steflayanto/environmental-chamber/better pics/IMG_0495.jpg

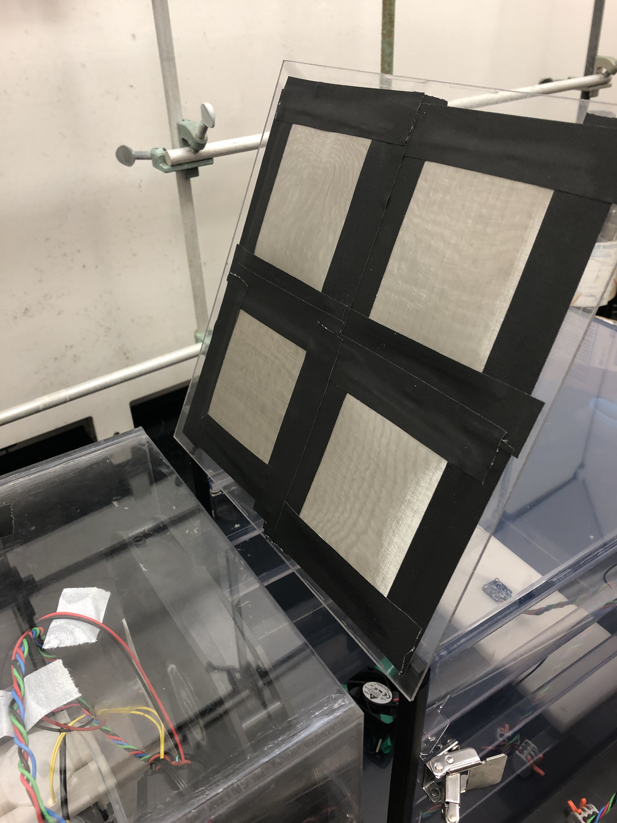
better pics/IMG_0495.jpg
