steflayanto/environmental-chamber/better pics/IMG_0489.jpg

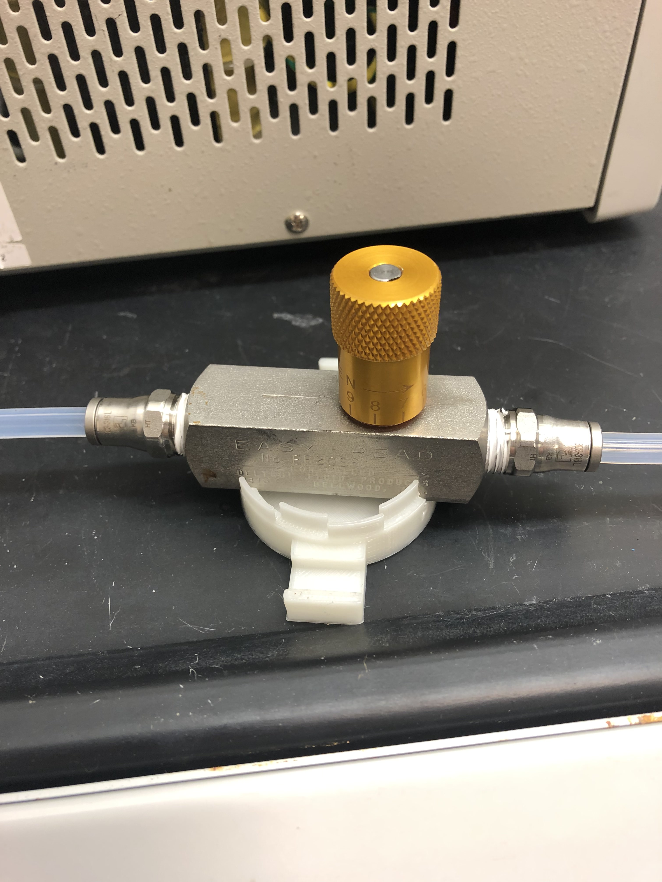
better pics/IMG_0489.jpg
