steflayanto/environmental-chamber/Test_Data/nomesh/8-20-19-nomesh notes.txt

humidifier started at 50 second mark for test
humidifier off at 693 second mark
