steflayanto/environmental-chamber/better pics/IMG_0487.jpg

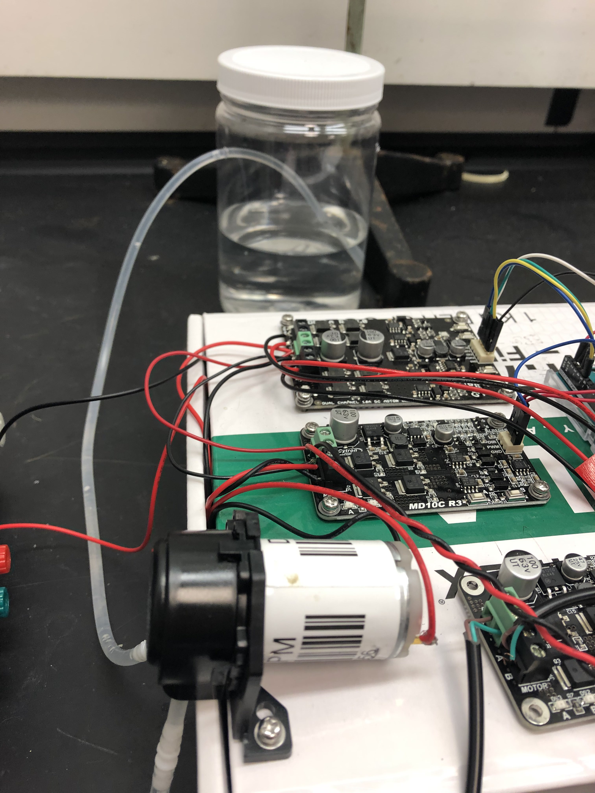
better pics/IMG_0487.jpg
