steflayanto/environmental-chamber/better pics/IMG_0488.jpg

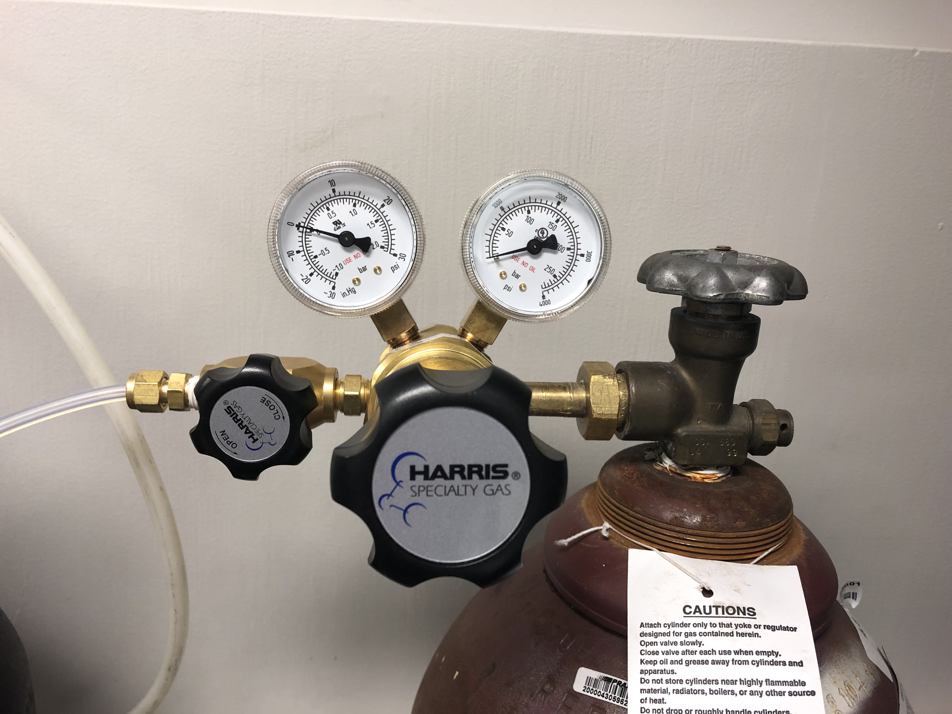
better pics/IMG_0488.jpg
