steflayanto/environmental-chamber/better pics/IMG_0490.jpg

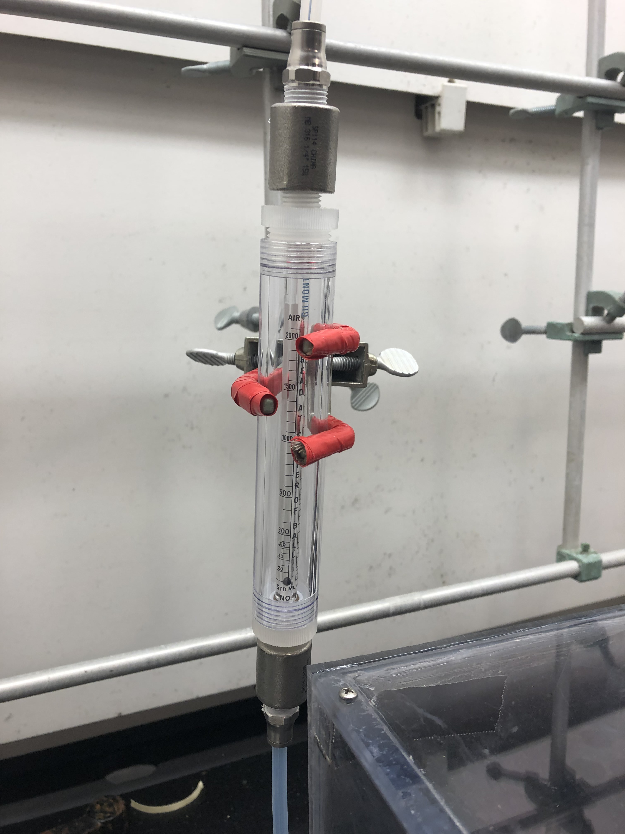
better pics/IMG_0490.jpg
