steflayanto/environmental-chamber/better pics/IMG_0491.jpg

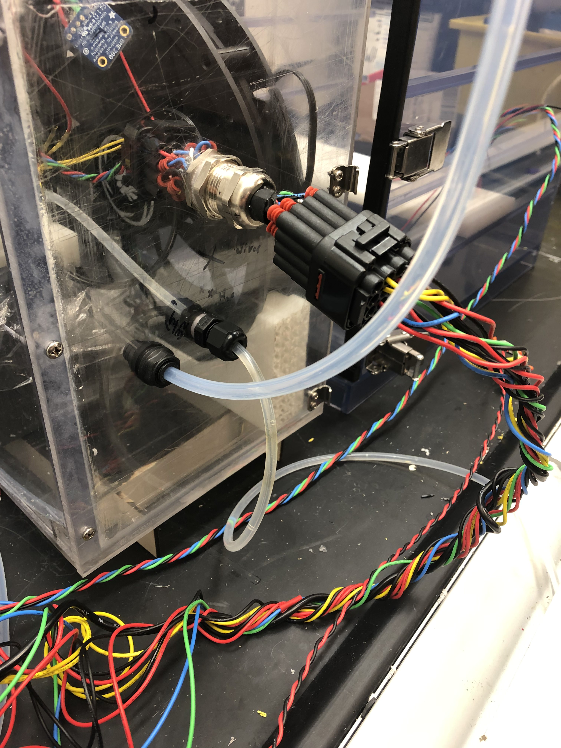
better pics/IMG_0491.jpg
