steflayanto/environmental-chamber/better pics/IMG_0492.jpg

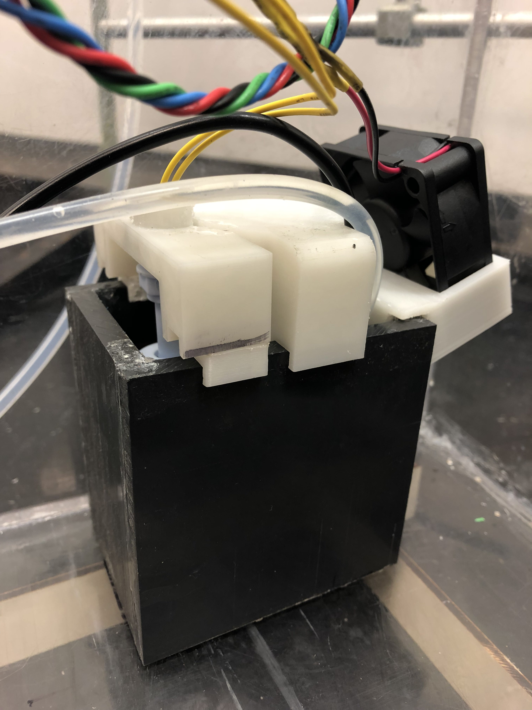
better pics/IMG_0492.jpg
