steflayanto/environmental-chamber/better pics/IMG_0493.jpg

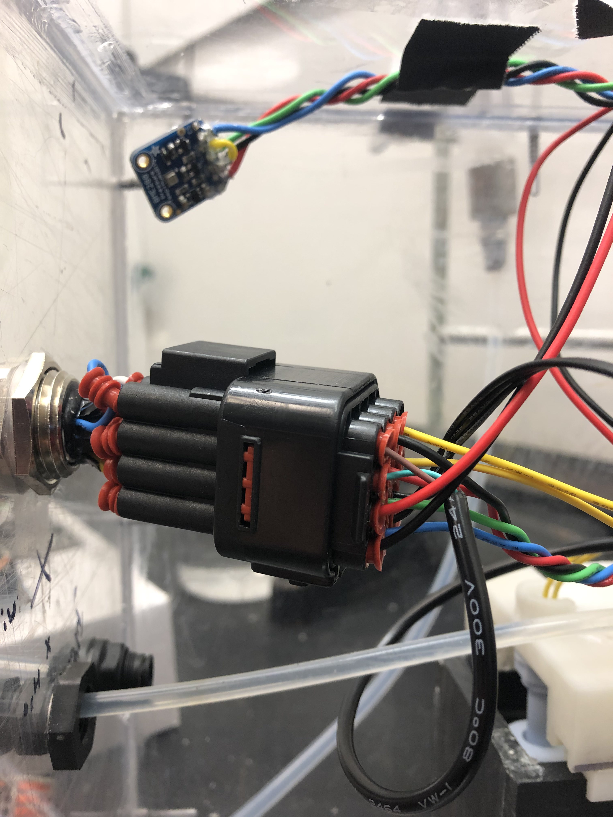
better pics/IMG_0493.jpg
