steflayanto/environmental-chamber/better pics/IMG_0494.jpg

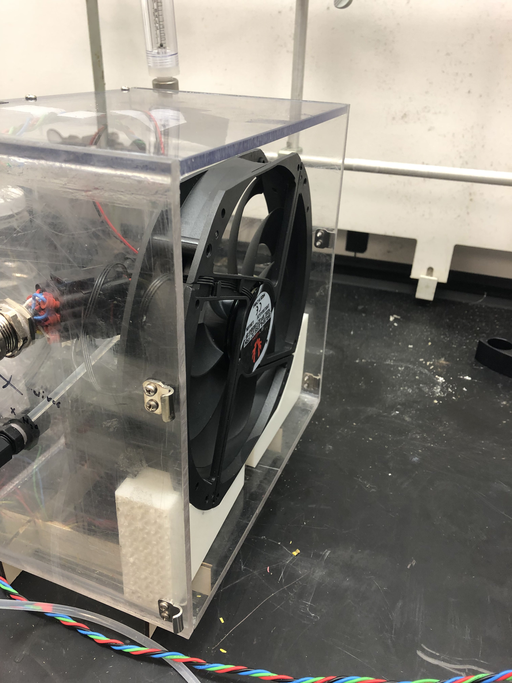
better pics/IMG_0494.jpg
