steflayanto/environmental-chamber/better pics/IMG_0496.jpg

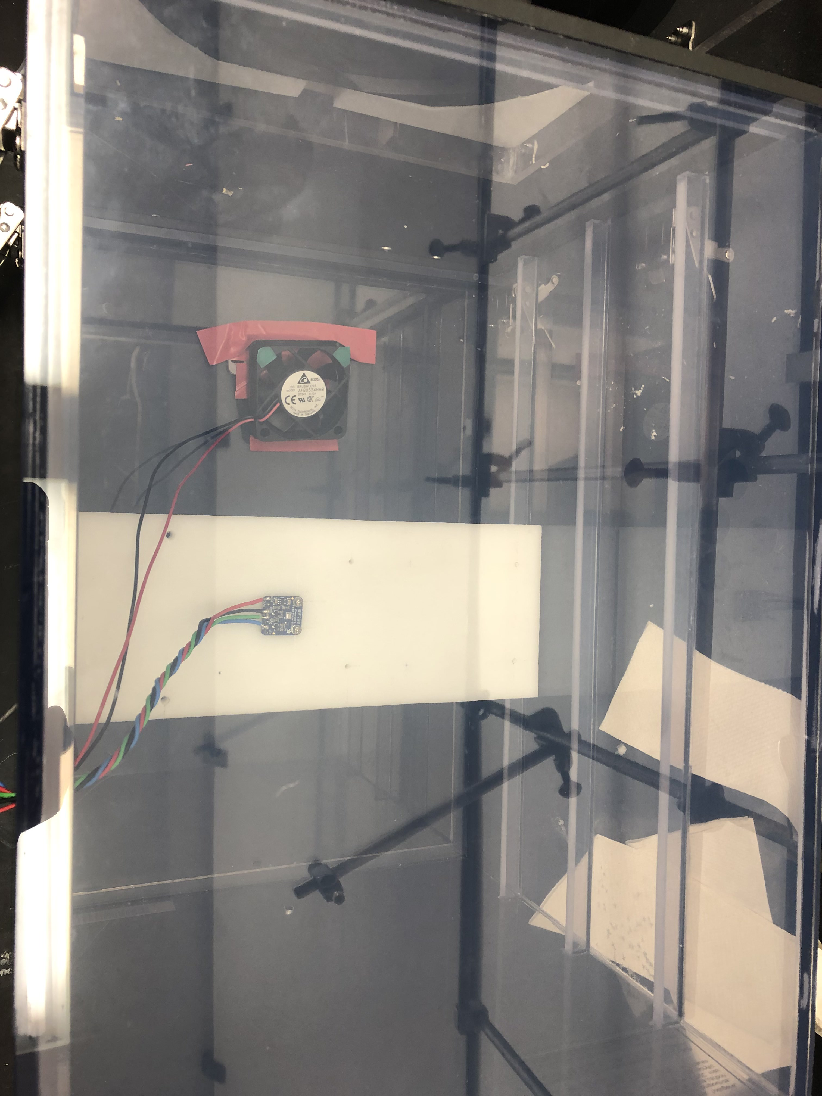
better pics/IMG_0496.jpg
