steflayanto/environmental-chamber/better pics/IMG_0498.jpg

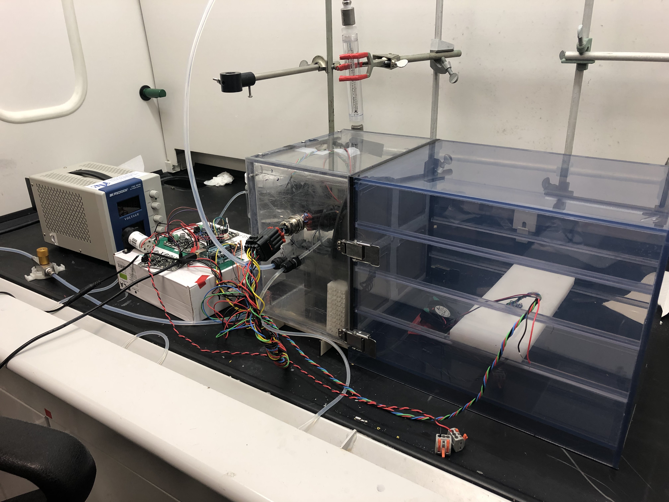
better pics/IMG_0498.jpg
