steflayanto/environmental-chamber/better pics/IMG_0499.jpg

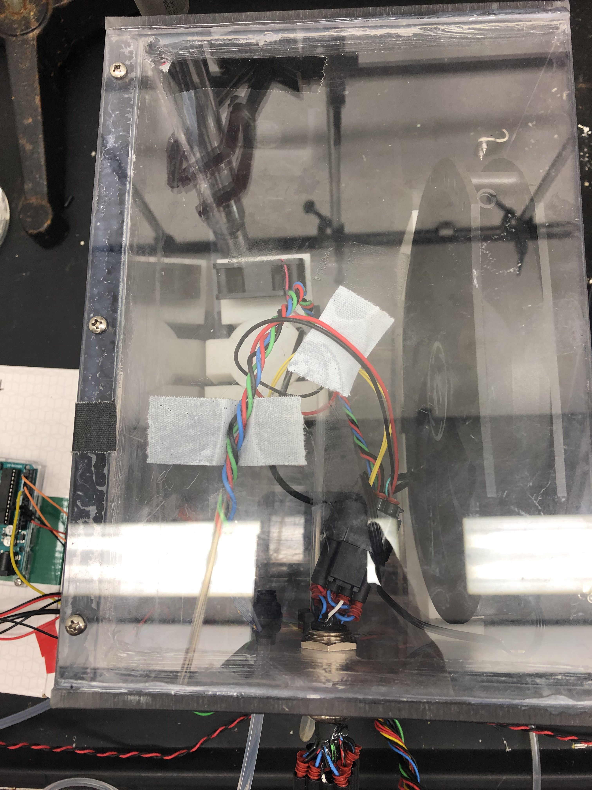
better pics/IMG_0499.jpg
