steflayanto/environmental-chamber/better pics/IMG_0500.jpg

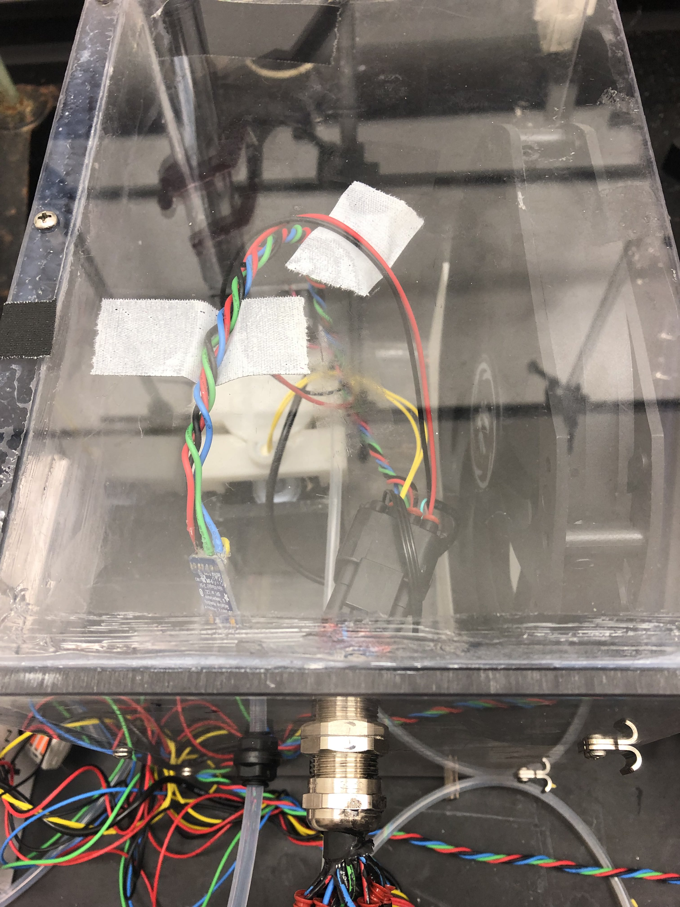
better pics/IMG_0500.jpg
