steflayanto/environmental-chamber/better pics/IMG_0501.jpg

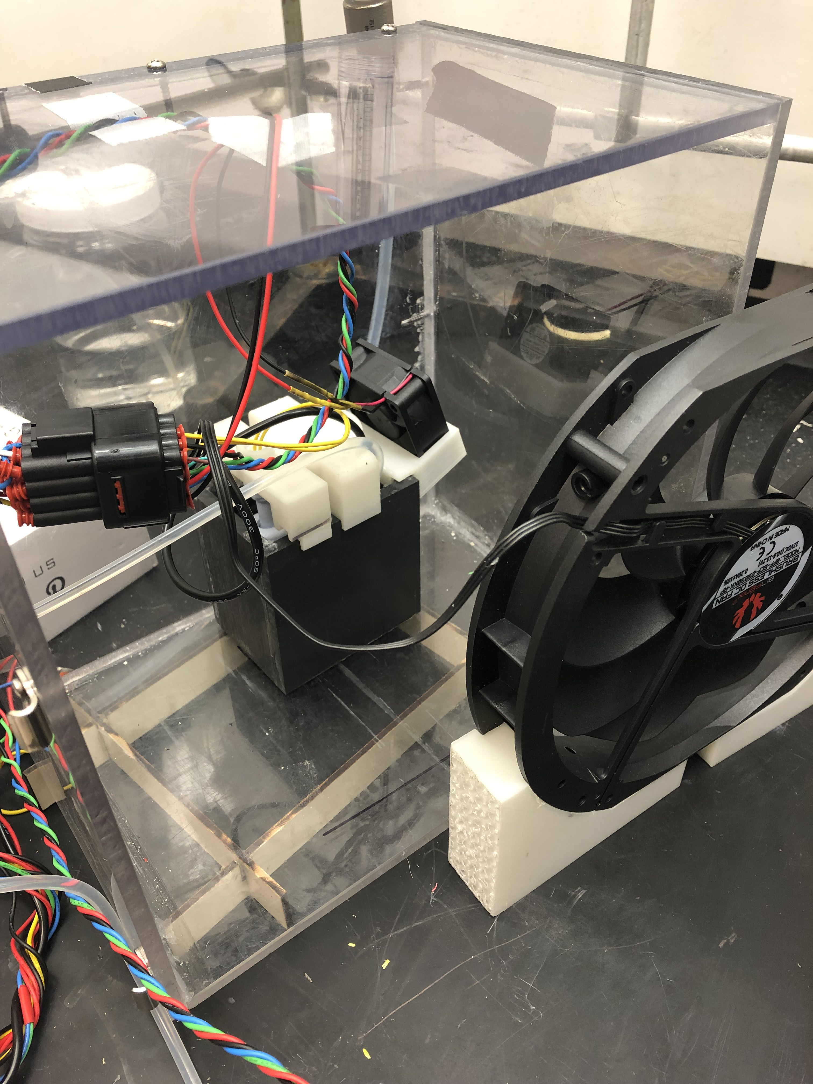
better pics/IMG_0501.jpg
