steflayanto/environmental-chamber/upverter schematic.png

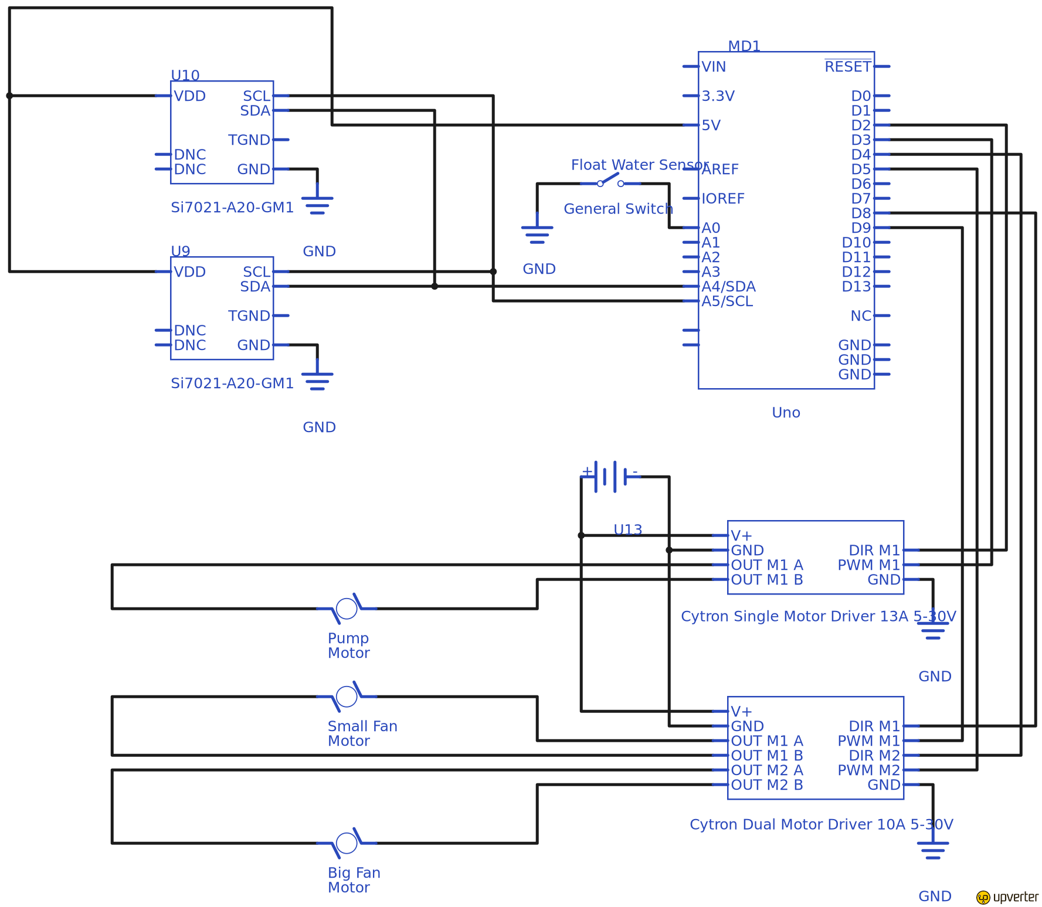
upverter schematic.png
