steflayanto/environmental-chamber/Test_Data/josh_tests/dry 60 graphs 1.docx

Graphs

Ran for 70 minutes instead of 20, you may want to resize this graph for yourself
