steflayanto/environmental-chamber/Test_Data/15micron/8-27-19 hum50.csv

Time | Hum | Water | Pump | SmallFan | BigFan | Wet Humidity | Dry Humidity | Wet Temperature | Dry Temperature | Wet Pressure | Dry Pressure
0 | 0 | 16 | 0 | 50 | 40 | 68.79 | 52.05 | 22.83 | 23.06 | 1011.63 | 1012.17
130 | 0 | 121 | 0 | 50 | 40 | 70.61 | 52.98 | 22.83 | 23.06 | 1011.63 | 1012.18
245 | 0 | 116 | 0 | 50 | 40 | 70.61 | 52.98 | 22.83 | 23.06 | 1011.63 | 1012.17
360 | 0 | 116 | 0 | 50 | 40 | 70.61 | 52.98 | 22.83 | 23.06 | 1011.62 | 1012.17
474 | 0 | 129 | 0 | 50 | 40 | 70.61 | 52.94 | 22.83 | 23.06 | 1011.62 | 1012.17
589 | 0 | 126 | 0 | 50 | 40 | 70.62 | 53.02 | 22.83 | 23.06 | 1011.62 | 1012.17
704 | 0 | 48 | 0 | 50 | 40 | 70.58 | 52.98 | 22.83 | 23.06 | 1011.62 | 1012.17
818 | 0 | 43 | 0 | 50 | 40 | 70.61 | 52.98 | 22.83 | 23.06 | 1011.62 | 1012.17
932 | 0 | 125 | 0 | 50 | 40 | 70.62 | 52.98 | 22.83 | 23.06 | 1011.62 | 1012.17
1047 | 0 | 119 | 0 | 50 | 40 | 70.62 | 52.98 | 22.83 | 23.06 | 1011.62 | 1012.17
1162 | 0 | 200 | 0 | 50 | 40 | 70.62 | 52.99 | 22.83 | 23.06 | 1011.62 | 1012.17
1276 | 0 | 125 | 0 | 50 | 40 | 70.60 | 53.01 | 22.83 | 23.06 | 1011.62 | 1012.17
1391 | 0 | 128 | 0 | 50 | 40 | 70.62 | 52.98 | 22.83 | 23.06 | 1011.62 | 1012.17
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
