steflayanto/environmental-chamber/Test_Data/15micron/8-28-19 hum100.csv

Time | Hum | Water | Pump | SmallFan | BigFan | Wet Humidity | Dry Humidity | Wet Temperature | Dry Temperature | Wet Pressure | Dry Pressure
0 | 0 | 97 | 0 | 50 | 40 | 59.98 | 55.71 | 22.53 | 22.61 | 1013.01 | 1013.68
131 | 0 | 117 | 0 | 50 | 40 | 61.32 | 56.82 | 22.53 | 22.61 | 1013.01 | 1013.68
246 | 0 | 120 | 0 | 50 | 40 | 61.34 | 56.83 | 22.53 | 22.61 | 1013.01 | 1013.68
360 | 0 | 118 | 0 | 50 | 40 | 61.35 | 56.84 | 22.53 | 22.61 | 1013.01 | 1013.69
475 | 0 | 129 | 0 | 50 | 40 | 61.37 | 56.82 | 22.53 | 22.61 | 1013.01 | 1013.69
590 | 0 | 50 | 0 | 50 | 40 | 61.37 | 56.82 | 22.53 | 22.61 | 1013.01 | 1013.69
704 | 0 | 136 | 0 | 50 | 40 | 61.39 | 56.82 | 22.53 | 22.61 | 1013.01 | 1013.69
818 | 0 | 131 | 0 | 50 | 40 | 61.39 | 56.82 | 22.53 | 22.61 | 1013.01 | 1013.69
933 | 0 | 204 | 0 | 50 | 40 | 61.40 | 56.81 | 22.53 | 22.61 | 1013.01 | 1013.69
1048 | 0 | 207 | 0 | 50 | 40 | 61.41 | 56.79 | 22.53 | 22.61 | 1013.01 | 1013.69
1162 | 0 | 126 | 0 | 50 | 40 | 61.45 | 56.82 | 22.52 | 22.61 | 1013.01 | 1013.69
1277 | 0 | 57 | 0 | 50 | 40 | 61.46 | 56.82 | 22.52 | 22.61 | 1013.01 | 1013.69
1391 | 0 | 52 | 0 | 50 | 40 | 61.48 | 56.82 | 22.52 | 22.61 | 1013.01 | 1013.69
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
