steflayanto/environmental-chamber/Test_Data/10micron/8-21-19 10micron.csv

Time | Hum | Water | Pump | Fan1 | Fan2 | Si Humidity | Wet Humidity | Dry Humidity | Si Temperature | BME2 Temperature | BME1 Temperature | BME2 Pressure | BME1 Pressure
0 | 0 | 312 | 0 | 50 | 40 | 94.31 | 83.92 | 58.16 | 22.01 | 22.46 | 22.5 | 1014.25 | 1013.98
148 | 0 | 208 | 0 | 50 | 40 | 94.23 | 86.51 | 59.4 | 21.99 | 22.46 | 22.5 | 1014.25 | 1013.98
295 | 0 | 205 | 0 | 50 | 40 | 94.25 | 86.5 | 59.39 | 22.02 | 22.46 | 22.5 | 1014.25 | 1013.98
441 | 0 | 264 | 0 | 50 | 40 | 94.22 | 86.5 | 59.39 | 21.98 | 22.46 | 22.5 | 1014.26 | 1013.98
589 | 0 | 264 | 0 | 50 | 40 | 94.21 | 86.51 | 59.39 | 21.99 | 22.46 | 22.5 | 1014.26 | 1013.98
736 | 0 | 333 | 0 | 50 | 40 | 94.23 | 86.51 | 59.41 | 22.01 | 22.46 | 22.5 | 1014.26 | 1013.98
884 | 0 | 200 | 0 | 50 | 40 | 94.24 | 86.51 | 59.39 | 22.03 | 22.46 | 22.5 | 1014.26 | 1013.98
1030 | 0 | 138 | 0 | 50 | 40 | 94.22 | 86.51 | 59.41 | 22.02 | 22.46 | 22.5 | 1014.26 | 1013.98
1178 | 0 | 141 | 0 | 50 | 40 | 94.24 | 86.51 | 59.4 | 22.01 | 22.46 | 22.5 | 1014.26 | 1013.98
1325 | 0 | 270 | 0 | 50 | 40 | 94.25 | 86.51 | 59.38 | 22.01 | 22.46 | 22.5 | 1014.26 | 1013.98
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
