steflayanto/environmental-chamber/Test_Data/15micron/8-21-19 hum100.csv

Time | Hum | Water | Pump | SmallFan | BigFan | Wet Humidity | Dry Humidity | Wet Temperature | Dry Temperature | Wet Pressure | Dry Pressure
0 | 0 | 49 | 0 | 0 | 0 | 75.95 | 56.93 | 23.02 | 22.74 | 1013.54 | 1013.70
129 | 0 | 69 | 0 | 0 | 0 | 78.17 | 58.11 | 23.02 | 22.74 | 1013.54 | 1013.70
243 | 0 | 75 | 0 | 0 | 0 | 78.19 | 58.11 | 23.02 | 22.74 | 1013.54 | 1013.71
357 | 0 | 77 | 0 | 0 | 0 | 78.21 | 58.14 | 23.02 | 22.74 | 1013.54 | 1013.71
472 | 0 | 78 | 0 | 0 | 0 | 78.21 | 58.07 | 23.02 | 22.74 | 1013.54 | 1013.71
586 | 0 | 78 | 0 | 0 | 0 | 78.22 | 58.10 | 23.02 | 22.74 | 1013.54 | 1013.71
700 | 0 | 80 | 0 | 0 | 0 | 78.23 | 58.10 | 23.02 | 22.74 | 1013.54 | 1013.71
815 | 0 | 80 | 0 | 0 | 0 | 78.24 | 58.10 | 23.02 | 22.74 | 1013.54 | 1013.71
929 | 0 | 80 | 0 | 0 | 0 | 78.25 | 58.11 | 23.02 | 22.74 | 1013.54 | 1013.71
1043 | 0 | 80 | 0 | 0 | 0 | 78.25 | 58.03 | 23.02 | 22.74 | 1013.54 | 1013.71
1158 | 0 | 81 | 0 | 0 | 0 | 78.26 | 58.11 | 23.02 | 22.74 | 1013.54 | 1013.71
1273 | 0 | 80 | 0 | 0 | 0 | 78.27 | 58.10 | 23.02 | 22.74 | 1013.54 | 1013.71
1386 | 0 | 80 | 0 | 0 | 0 | 78.25 | 58.11 | 23.02 | 22.74 | 1013.54 | 1013.71
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
