steflayanto/environmental-chamber/Test_Data/nomesh/8-20-19-nomesh(humidifier on at 50seconds).csv

Time | Water | Pump | Fan1 | Fan2 | Si Humidity | Dry Humidity | Wet Humidity | Si Temperature | BME1 Temperature | BME2 Temperature
0 | 185 | 0 | 50 | 40 | 68.74 | 49.53 | 59.94 | 22.02 | 24.24 | 22.49
139 | 137 | 0 | 50 | 40 | 68.68 | 50.36 | 61.29 | 22.04 | 24.24 | 22.49
279 | 290 | 0 | 50 | 40 | 68.68 | 50.37 | 61.3 | 22.03 | 24.24 | 22.49
419 | 94 | 0 | 50 | 40 | 68.7 | 50.37 | 61.3 | 22.04 | 24.24 | 22.49
559 | 186 | 0 | 50 | 40 | 68.71 | 50.38 | 61.31 | 22.02 | 24.24 | 22.49
698 | 230 | 0 | 50 | 40 | 68.71 | 50.38 | 61.32 | 22.03 | 24.24 | 22.49
838 | 178 | 0 | 50 | 40 | 68.72 | 50.38 | 61.32 | 22.04 | 24.24 | 22.49
978 | 245 | 0 | 50 | 40 | 68.73 | 50.39 | 61.33 | 22.03 | 24.24 | 22.49
1118 | 176 | 0 | 50 | 40 | 68.76 | 50.39 | 61.33 | 22.01 | 24.24 | 22.49
1258 | 257 | 0 | 50 | 40 | 68.75 | 50.39 | 61.34 | 22.04 | 24.24 | 22.49
1397 | 78 | 0 | 50 | 40 | 68.76 | 50.4 | 61.34 | 22.04 | 24.24 | 22.49
1538 | 330 | 0 | 50 | 40 | 68.75 | 50.37 | 61.35 | 22.03 | 24.24 | 22.49
1677 | 117 | 0 | 50 | 40 | 68.77 | 50.41 | 61.34 | 22.04 | 24.24 | 22.49
1817 | 168 | 0 | 50 | 40 | 68.79 | 50.4 | 61.35 | 22.05 | 24.24 | 22.49
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
