steflayanto/environmental-chamber/Test_Data/08-14-19-chamber-test-(no gas).csv

Time | Water | Pump | Fan1 | Fan2 | Si Humidity | BME1 Humidity | BME2 Humidity | Si Temperature | BME1 Temperature | BME2 Temperature
0 | 164 | 0 | 0 | 0 | 64.74 | 50.95 | 54.58 | 22.48 | 23.49 | 23.05
139 | 905 | 0 | 0 | 0 | 64.71 | 50.95 | 54.57 | 22.48 | 23.49 | 23.05
278 | 143 | 0 | 0 | 0 | 64.68 | 50.95 | 54.58 | 22.49 | 23.49 | 23.05
418 | 792 | 0 | 0 | 0 | 64.71 | 50.94 | 54.57 | 22.49 | 23.49 | 23.05
558 | 439 | 0 | 0 | 0 | 64.7 | 50.94 | 54.58 | 22.5 | 23.49 | 23.05
698 | 77 | 0 | 0 | 0 | 64.71 | 50.95 | 54.56 | 22.48 | 23.49 | 23.05
837 | 1002 | 0 | 0 | 0 | 64.72 | 50.94 | 54.56 | 22.5 | 23.49 | 23.05
976 | 165 | 0 | 0 | 0 | 64.74 | 50.94 | 54.57 | 22.5 | 23.49 | 23.05
1117 | 241 | 0 | 0 | 0 | 64.73 | 50.95 | 54.58 | 22.49 | 23.49 | 23.05
1256 | 664 | 0 | 0 | 0 | 64.74 | 50.93 | 54.57 | 22.5 | 23.49 | 23.05
1396 | 31 | 0 | 0 | 0 | 64.73 | 50.94 | 54.57 | 22.51 | 23.49 | 23.06
1536 | 945 | 0 | 0 | 0 | 64.76 | 50.93 | 54.56 | 22.49 | 23.49 | 23.06
1676 | 8 | 0 | 0 | 0 | 64.75 | 50.94 | 54.56 | 22.49 | 23.49 | 23.06
1815 | 145 | 0 | 0 | 0 | 64.77 | 50.94 | 54.56 | 22.5 | 23.49 | 23.06
1955 | 948 | 0 | 0 | 0 | 64.78 | 50.94 | 54.56 | 22.48 | 23.49 | 23.06
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
