steflayanto/environmental-chamber/Test_Data/08-29-19 experimenting with values (last test).csv

Time | Hum | Water | Pump | SmallFan | BigFan | Wet Humidity | Dry Humidity | Wet Temperature | Dry Temperature | Wet Pressure | Dry Pressure
0 | 0 | 66 | 0 | 0 | 0 | 90.87 | 64.99 | 22.39 | 23.02 | 1013.38 | 1013.95
128 | 0 | 94 | 0 | 0 | 0 | 93.81 | 66.64 | 22.39 | 23.02 | 1013.38 | 1013.95
242 | 0 | 103 | 0 | 0 | 0 | 93.80 | 66.60 | 22.39 | 23.02 | 1013.38 | 1013.95
357 | 0 | 107 | 0 | 0 | 0 | 93.82 | 66.64 | 22.39 | 23.02 | 1013.38 | 1013.95
472 | 0 | 108 | 0 | 0 | 0 | 93.80 | 66.64 | 22.39 | 23.02 | 1013.38 | 1013.95
586 | 0 | 109 | 0 | 0 | 0 | 93.81 | 66.64 | 22.39 | 23.02 | 1013.38 | 1013.95
701 | 0 | 109 | 0 | 0 | 0 | 93.81 | 66.64 | 22.39 | 23.02 | 1013.38 | 1013.95
816 | 0 | 109 | 0 | 0 | 0 | 93.79 | 66.63 | 22.39 | 23.02 | 1013.38 | 1013.95
930 | 0 | 109 | 0 | 0 | 0 | 93.79 | 66.63 | 22.39 | 23.02 | 1013.37 | 1013.95
1044 | 0 | 108 | 0 | 0 | 0 | 93.77 | 66.65 | 22.39 | 23.02 | 1013.37 | 1013.95
1159 | 0 | 108 | 0 | 0 | 0 | 93.79 | 66.65 | 22.40 | 23.02 | 1013.37 | 1013.95
1273 | 0 | 107 | 0 | 0 | 0 | 93.78 | 66.65 | 22.40 | 23.02 | 1013.37 | 1013.95
1388 | 0 | 106 | 0 | 0 | 0 | 93.79 | 66.65 | 22.40 | 23.02 | 1013.37 | 1013.95
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
