steflayanto/environmental-chamber/Test_Data/08-29-19 experimenting with values.csv

Time | Hum | Water | Pump | SmallFan | BigFan | Wet Humidity | Dry Humidity | Wet Temperature | Dry Temperature | Wet Pressure | Dry Pressure
0 | 0 | 50 | 0 | 0 | 40 | 71.87 | 55.84 | 22.41 | 22.73 | 1013.15 | 1013.79
130 | 0 | 56 | 0 | 0 | 40 | 73.86 | 56.92 | 22.41 | 22.73 | 1013.15 | 1013.79
244 | 0 | 63 | 0 | 0 | 40 | 73.92 | 56.91 | 22.41 | 22.73 | 1013.15 | 1013.79
359 | 0 | 146 | 0 | 0 | 40 | 73.95 | 56.82 | 22.40 | 22.73 | 1013.15 | 1013.79
474 | 0 | 146 | 0 | 0 | 40 | 74.04 | 56.92 | 22.40 | 22.73 | 1013.15 | 1013.79
588 | 0 | 66 | 0 | 0 | 40 | 74.15 | 56.92 | 22.40 | 22.73 | 1013.15 | 1013.79
702 | 0 | 69 | 0 | 0 | 40 | 74.21 | 56.92 | 22.40 | 22.73 | 1013.15 | 1013.79
817 | 0 | 71 | 0 | 0 | 40 | 74.27 | 56.91 | 22.40 | 22.73 | 1013.15 | 1013.79
931 | 0 | 153 | 0 | 0 | 40 | 74.33 | 56.93 | 22.40 | 22.74 | 1013.15 | 1013.80
1046 | 0 | 153 | 0 | 0 | 40 | 74.37 | 56.86 | 22.40 | 22.74 | 1013.15 | 1013.80
1161 | 0 | 72 | 0 | 0 | 40 | 74.51 | 56.92 | 22.40 | 22.74 | 1013.15 | 1013.80
1274 | 0 | 72 | 0 | 0 | 40 | 74.57 | 56.92 | 22.40 | 22.74 | 1013.14 | 1013.80
1389 | 0 | 75 | 0 | 0 | 40 | 74.62 | 56.92 | 22.40 | 22.74 | 1013.14 | 1013.80
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
