steflayanto/environmental-chamber/Test_Data/09-03-19 const fan.csv

Time | Hum | Water | Pump | SmallFan | BigFan | Wet Humidity | Dry Humidity | Wet Temperature | Dry Temperature | Wet Pressure | Dry Pressure
0 | 0 | 54 | 0 | 0 | 30 | 80.79 | 56.99 | 22.25 | 22.81 | 1015.76 | 1016.32
130 | 0 | 68 | 0 | 0 | 30 | 80.79 | 57.07 | 22.25 | 22.81 | 1015.76 | 1016.32
245 | 0 | 71 | 0 | 0 | 30 | 80.80 | 57.07 | 22.25 | 22.81 | 1015.76 | 1016.32
360 | 0 | 156 | 0 | 0 | 30 | 80.82 | 57.07 | 22.25 | 22.81 | 1015.76 | 1016.32
474 | 0 | 158 | 0 | 0 | 30 | 80.80 | 57.13 | 22.25 | 22.81 | 1015.76 | 1016.32
589 | 0 | 160 | 0 | 0 | 30 | 80.80 | 57.08 | 22.25 | 22.81 | 1015.76 | 1016.32
704 | 0 | 161 | 0 | 0 | 30 | 80.80 | 57.07 | 22.25 | 22.81 | 1015.76 | 1016.32
819 | 0 | 163 | 0 | 0 | 30 | 80.80 | 57.07 | 22.25 | 22.81 | 1015.76 | 1016.32
933 | 0 | 83 | 0 | 0 | 30 | 80.83 | 57.07 | 22.25 | 22.81 | 1015.76 | 1016.33
1047 | 0 | 85 | 0 | 0 | 30 | 80.81 | 57.08 | 22.25 | 22.81 | 1015.76 | 1016.32
1162 | 0 | 87 | 0 | 0 | 30 | 80.80 | 57.03 | 22.25 | 22.81 | 1015.76 | 1016.32
1276 | 0 | 88 | 0 | 0 | 30 | 80.80 | 57.07 | 22.25 | 22.81 | 1015.76 | 1016.32
1391 | 0 | 89 | 0 | 0 | 30 | 80.80 | 57.07 | 22.25 | 22.81 | 1015.76 | 1016.32
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
