steflayanto/environmental-chamber/Test_Data/09-03-19 const humidity vary fan.csv

Time | Hum | Water | Pump | SmallFan | BigFan | Wet Humidity | Dry Humidity | Wet Temperature | Dry Temperature | Wet Pressure | Dry Pressure
0 | 0 | 63 | 0 | 0 | 30 | 72.43 | 56.80 | 22.74 | 23.07 | 1015.63 | 1016.20
129 | 0 | 66 | 0 | 0 | 30 | 72.42 | 56.89 | 22.74 | 23.07 | 1015.63 | 1016.20
243 | 0 | 69 | 0 | 0 | 30 | 72.43 | 56.91 | 22.74 | 23.07 | 1015.63 | 1016.20
358 | 0 | 72 | 0 | 0 | 30 | 72.42 | 56.89 | 22.74 | 23.07 | 1015.63 | 1016.20
473 | 0 | 76 | 0 | 0 | 30 | 72.43 | 56.89 | 22.74 | 23.07 | 1015.63 | 1016.20
587 | 0 | 76 | 0 | 0 | 30 | 72.43 | 56.89 | 22.74 | 23.07 | 1015.63 | 1016.20
702 | 0 | 158 | 0 | 0 | 30 | 72.44 | 56.89 | 22.74 | 23.07 | 1015.63 | 1016.20
817 | 0 | 159 | 0 | 0 | 30 | 72.44 | 56.95 | 22.74 | 23.07 | 1015.63 | 1016.20
932 | 0 | 159 | 0 | 0 | 30 | 72.43 | 56.96 | 22.74 | 23.07 | 1015.63 | 1016.21
1046 | 0 | 160 | 0 | 0 | 30 | 72.42 | 56.89 | 22.74 | 23.07 | 1015.62 | 1016.21
1161 | 0 | 161 | 0 | 0 | 30 | 72.45 | 56.89 | 22.74 | 23.07 | 1015.63 | 1016.21
1276 | 0 | 162 | 0 | 0 | 30 | 72.46 | 56.89 | 22.74 | 23.07 | 1015.63 | 1016.21
1390 | 0 | 161 | 0 | 0 | 30 | 72.45 | 56.89 | 22.74 | 23.07 | 1015.63 | 1016.21
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
