steflayanto/environmental-chamber/Test_Data/josh_tests/9_11_19-d60-1.csv

Time | Hum | Water | Pump | SmallFan | BigFan | Wet Humidity | Dry Humidity | Wet Temperature | Dry Temperature | Wet Pressure | Dry Pressure
1153 | 0 | 100 | 0 | 0 | 0 | 60.66 | 56.99 | 22.85 | 22.66 | 1019.82 | 1020.22
2168 | 0 | 113 | 0 | 0 | 0 | 60.59 | 57 | 22.85 | 22.66 | 1019.82 | 1020.22
3183 | 0 | 114 | 0 | 0 | 100 | 60.51 | 57 | 22.85 | 22.66 | 1019.82 | 1020.22
4198 | 0 | 116 | 0 | 0 | 100 | 60.47 | 57.01 | 22.85 | 22.66 | 1019.83 | 1020.21
5213 | 0 | 132 | 0 | 0 | 100 | 60.43 | 57.02 | 22.85 | 22.66 | 1019.82 | 1020.21
6227 | 0 | 111 | 0 | 0 | 100 | 60.7 | 57.03 | 22.85 | 22.66 | 1019.83 | 1020.22
7242 | 0 | 93 | 0 | 0 | 100 | 60.9 | 57.04 | 22.84 | 22.66 | 1019.82 | 1020.22
8257 | 0 | 94 | 0 | 0 | 100 | 61.07 | 57.05 | 22.84 | 22.65 | 1019.8 | 1020.22
9272 | 0 | 90 | 0 | 0 | 100 | 61.21 | 57.05 | 22.83 | 22.65 | 1019.8 | 1020.23
10286 | 0 | 87 | 0 | 0 | 100 | 61.35 | 57.06 | 22.82 | 22.65 | 1019.79 | 1020.22
11301 | 0 | 108 | 0 | 0 | 100 | 61.47 | 57.07 | 22.81 | 22.65 | 1019.78 | 1020.22
12316 | 0 | 138 | 0 | 0 | 100 | 61.63 | 57.08 | 22.79 | 22.65 | 1019.78 | 1020.22
13331 | 0 | 137 | 0 | 0 | 100 | 61.75 | 57.1 | 22.78 | 22.65 | 1019.78 | 1020.23
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
