steflayanto/environmental-chamber/Test_Data/humidity over time in dry.png

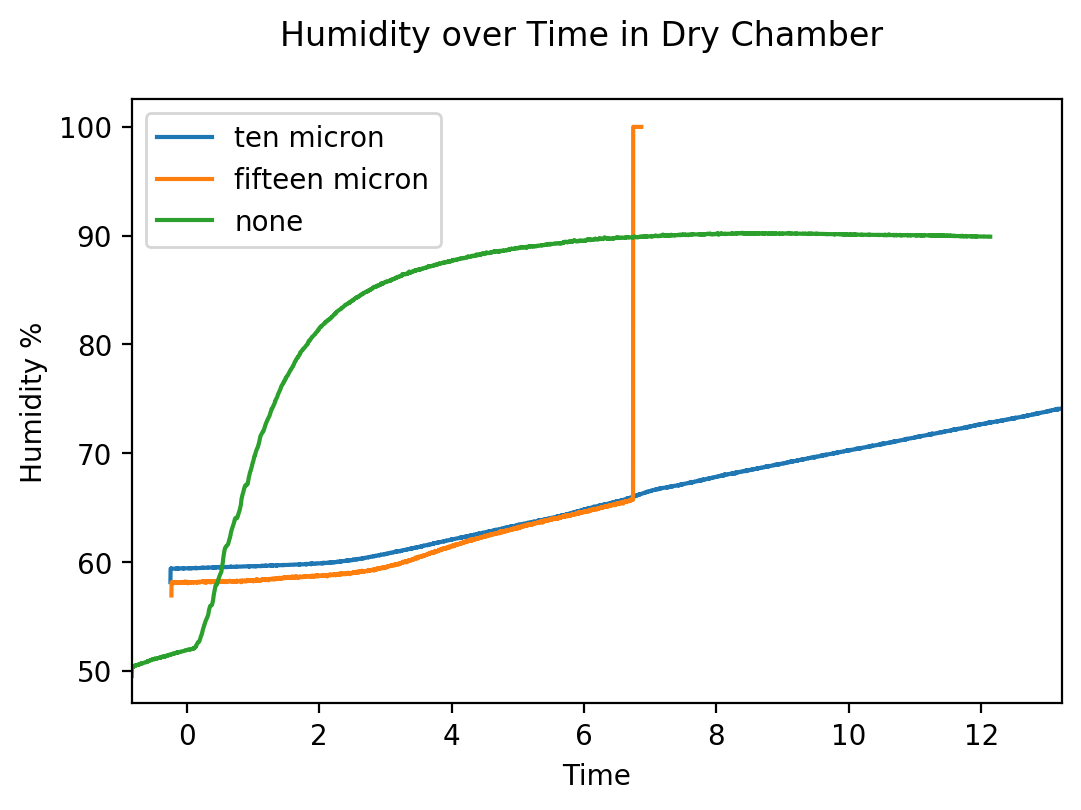
Test_Data/humidity over time in dry.png
