steflayanto/environmental-chamber/Test_Data/humidity over time in wet.png

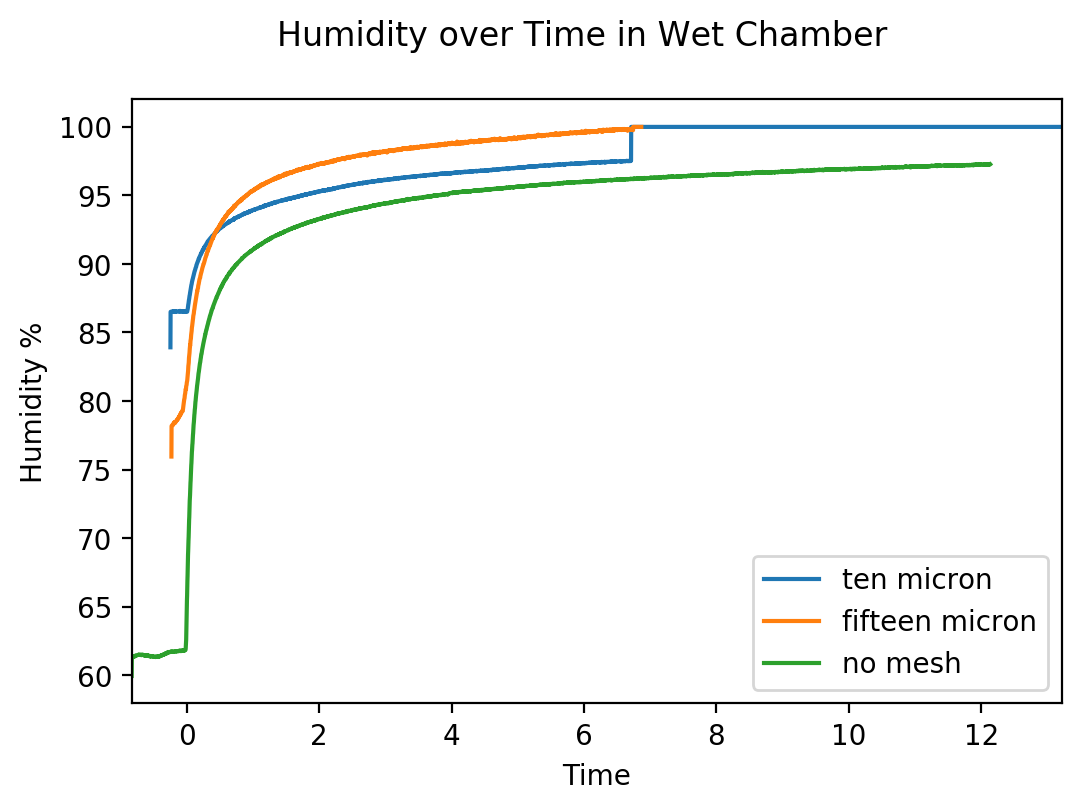
Test_Data/humidity over time in wet.png
