steflayanto/environmental-chamber/(commit log)

2019-08-12 code not working despite no changes
    [Chamber_Controller.ino]
2019-08-14 added test data, modified interface slightly
    [08-14-19 10.40 chamber test (no gas).csv]
2019-08-21 working code with humidifier
    [8-21-19-10micron.csv, test8-20-19-nomesh(humidifier on at 50seconds).csv, working sheet.xlsx]
2019-08-22 added jupyternotebook
    [08-14-19-chamber-test-(no gas).csv, 8-20-19-nomesh(humidifier on at 50seconds).csv, 8-21-19-10micron.csv, 8-21-19-15micron.csv, test8-20-19-nomesh(humidifier on at 50seconds).csv, working sheet.xlsx]
2019-08-30 added new test data
    [08-29-19 experimenting with values (last test).csv, 08-29-19 experimenting with values.csv, 8-20-19-nomesh(humidifier on at 50seconds).csv, 8-21-19 10micron.csv, 8-21-19 hum100.csv, 8-27-19 hum50.csv, 8-28-19 hum100.csv]
2019-09-03 new test data, const hum
    [09-03-19 const fan.csv, 09-03-19 const humidity vary fan.csv]
2019-09-12 added test command, fixed CSV newline problem
    [9_11_19-d60-1.csv, 9_11_19-d60-2.csv, 9_11_19-d60-3.csv, 9_11_19-d60-4.csv, 9_11_19-d60-5.csv, 9_12_19-d60-6.csv]
2019-09-12 70 tests
    [9_10_19 dry 80 manual test 1.csv, 9_10_19 dry run with fan3 100 fan2 0 9holes no mesh.csv, 9_10_19 dry run with fan3 100 fan2 0 window mesh.csv, 9_12_19-d70-1.csv, 9_12_19-d70-2.csv, 9_5_19 Standard run 9 mesh.csv, 9_5_19 standard run window mesh.csv, 9_6_19 20min 9Grid Mesh.csv]
2019-09-12 data for 80 1
    [9_12_19-d80-1.csv]
2019-09-12 80 data 2
    [9_12_19-d80-2.csv]
2019-09-13 Wall and Block data, block is more real
    [9_13_19-dwall-1.csv, 9_13_19-dwall-2.csv]
2019-09-16 wrap data
    [9_16_19-dwrap-1.csv, 9_16_19-dwrap-2.csv]
2019-09-20 new testing
    [9_19_19-dmesh3-1.csv, 9_20_19-dmin-fail.csv, 9_20_19-dwrap50-1.csv, 9_20_19-dwrapblockmin-1.csv]
