steflayanto/environmental-chamber/better pics/IMG_0486.jpg

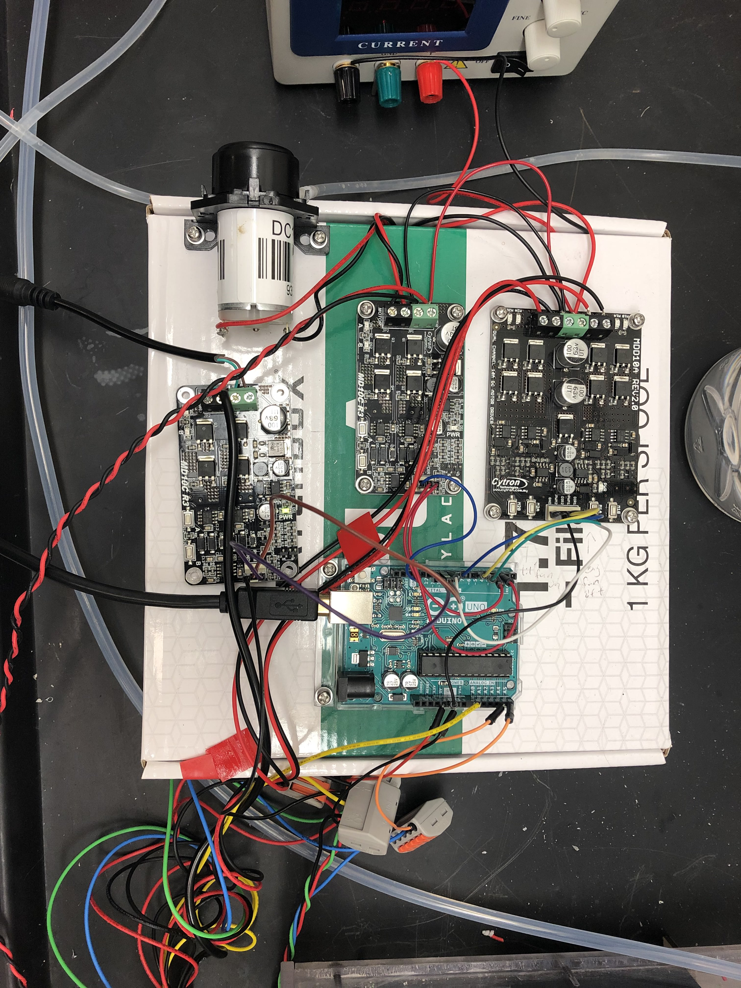
better pics/IMG_0486.jpg
